silverXnoise/star-tracker/2377686/Star tracker - 2377686/images/729f3aaed75539d28fd95f96ef13848c.png

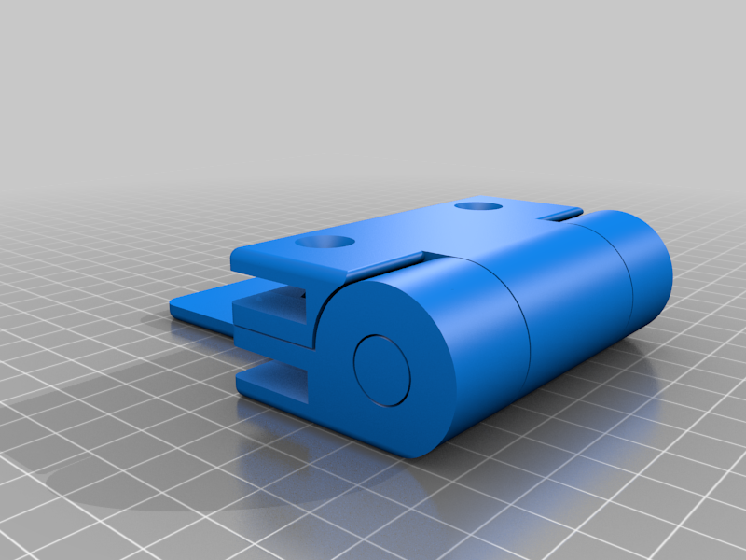
2377686/Star tracker - 2377686/images/729f3aaed75539d28fd95f96ef13848c.png
