silverXnoise/star-tracker/2377686/Star tracker - 2377686/images/P6115772_DxO.jpg

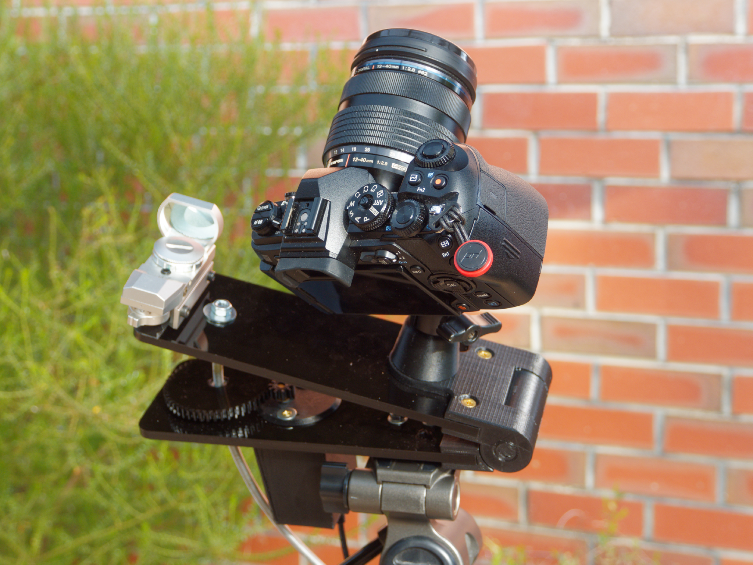
2377686/Star tracker - 2377686/images/P6115772_DxO.jpg
