silverXnoise/star-tracker/README.md

# star-tracker
Barn-door style star tracking mount for digital cameras
