silverXnoise/star-tracker/2377686/Star tracker - 2377686/images/2ce9118109a8682bafb783a583b2ab66.png

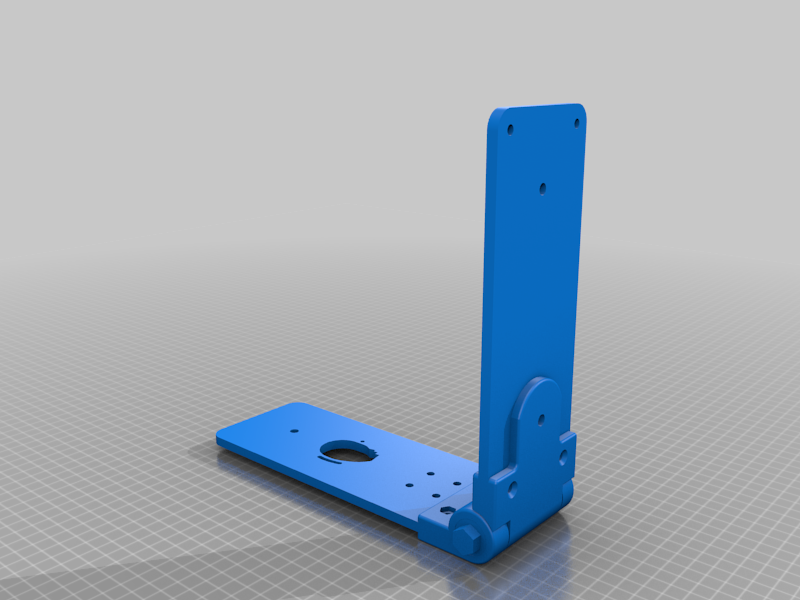
2377686/Star tracker - 2377686/images/2ce9118109a8682bafb783a583b2ab66.png
