silverXnoise/star-tracker/2377686/Star tracker - 2377686/images/5c67f773585e85fc1f77e3057208efd5.png

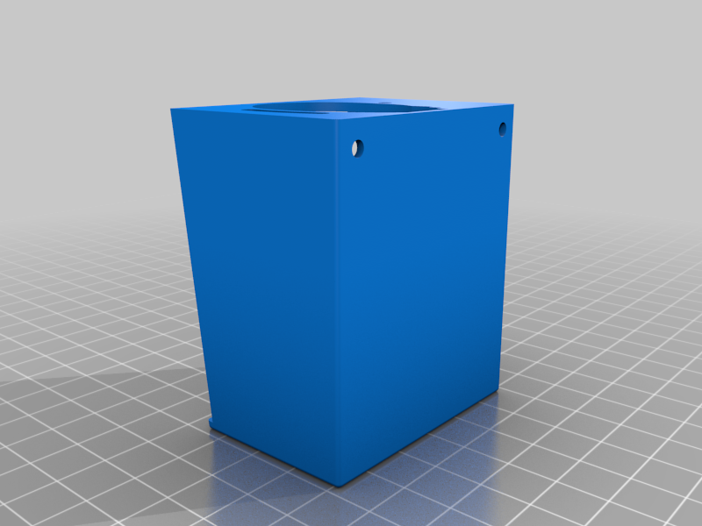
2377686/Star tracker - 2377686/images/5c67f773585e85fc1f77e3057208efd5.png
