silverXnoise/star-tracker/2377686/Star tracker - 2377686/images/5d4a4bc1e4c33faa9d85817317d7535b.png

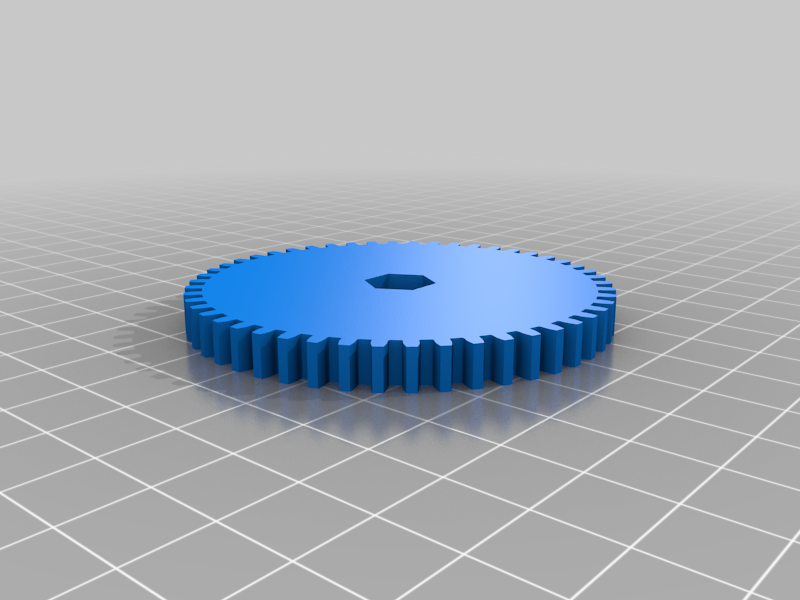
2377686/Star tracker - 2377686/images/5d4a4bc1e4c33faa9d85817317d7535b.png
