silverXnoise/star-tracker/2377686/Star tracker - 2377686/images/7db2c85e6fdb01128ebda68ac9ac53ee.png

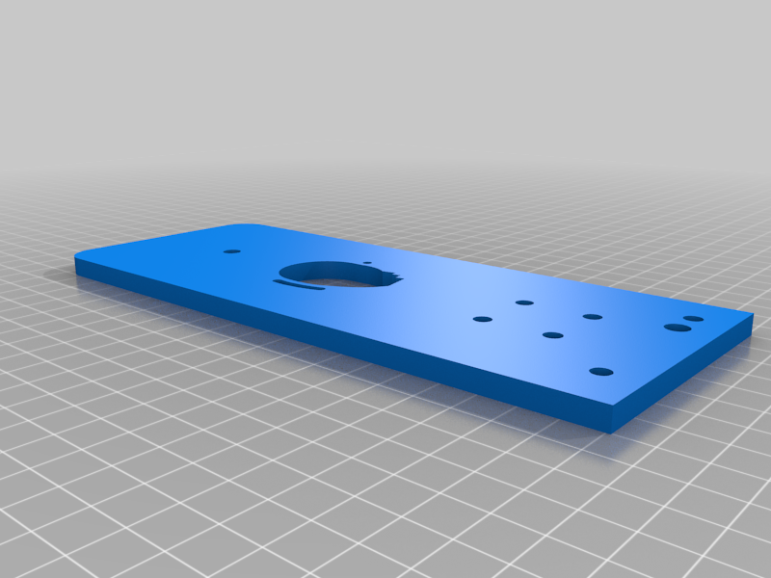
2377686/Star tracker - 2377686/images/7db2c85e6fdb01128ebda68ac9ac53ee.png
