silverXnoise/star-tracker/2377686/Star tracker - 2377686/images/26cda3ffb89d20ad288b1fc1c3eebb6a.png

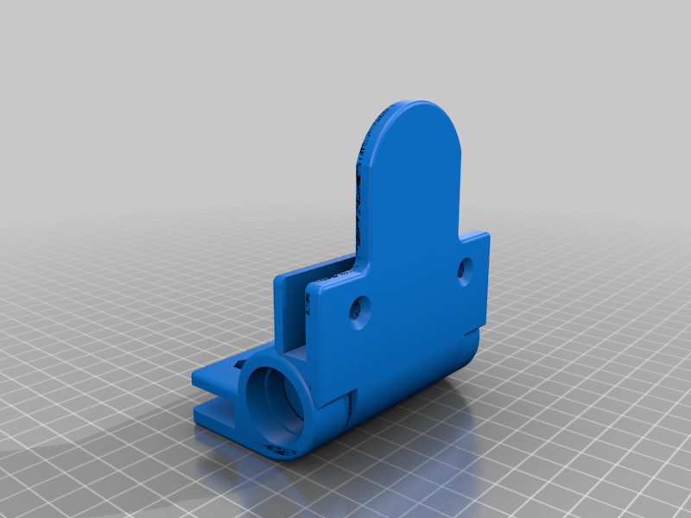
2377686/Star tracker - 2377686/images/26cda3ffb89d20ad288b1fc1c3eebb6a.png
