silverXnoise/star-tracker/2377686/Star tracker - 2377686/images/72ef2f90839a677f4413f9d10a9dccd0.png

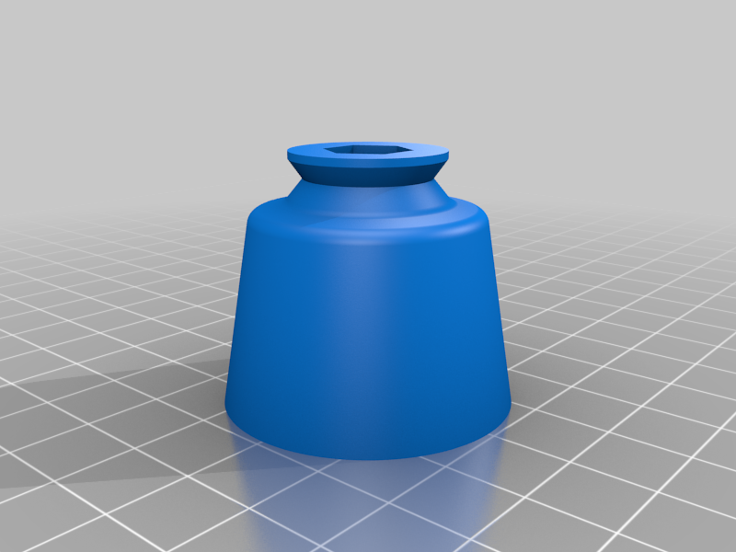
2377686/Star tracker - 2377686/images/72ef2f90839a677f4413f9d10a9dccd0.png
