silverXnoise/star-tracker/2377686/Star tracker - 2377686/images/74a210dba58315fb1523b2976943516c.png

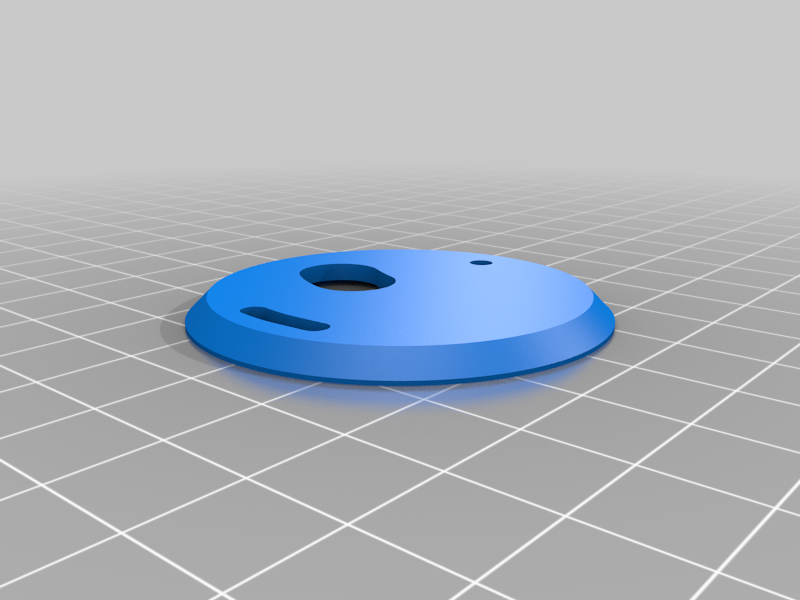
2377686/Star tracker - 2377686/images/74a210dba58315fb1523b2976943516c.png
