silverXnoise/star-tracker/2377686/Star tracker - 2377686/images/64908824dff2cc5d9ca0d351f06bbc23.png

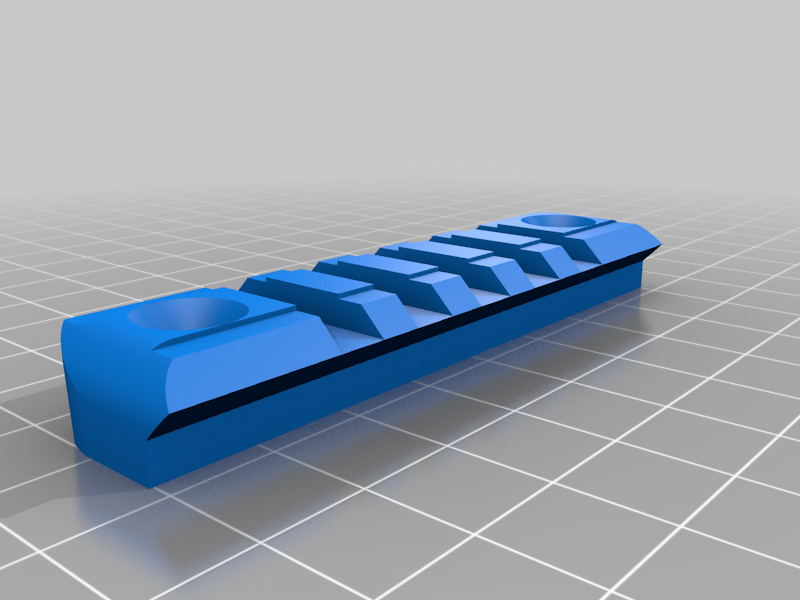
2377686/Star tracker - 2377686/images/64908824dff2cc5d9ca0d351f06bbc23.png
