silverXnoise/star-tracker/2377686/Star tracker - 2377686/images/189839108b3914b2a57e7a768595913c.png

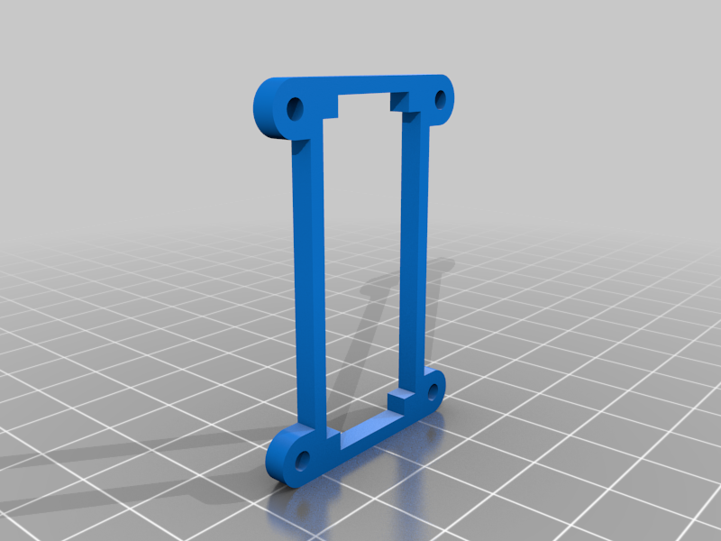
2377686/Star tracker - 2377686/images/189839108b3914b2a57e7a768595913c.png
