silverXnoise/star-tracker/2377686/Star tracker - 2377686/images/a8d63f5ceae4c1766cb8cda900a1fcd2.png

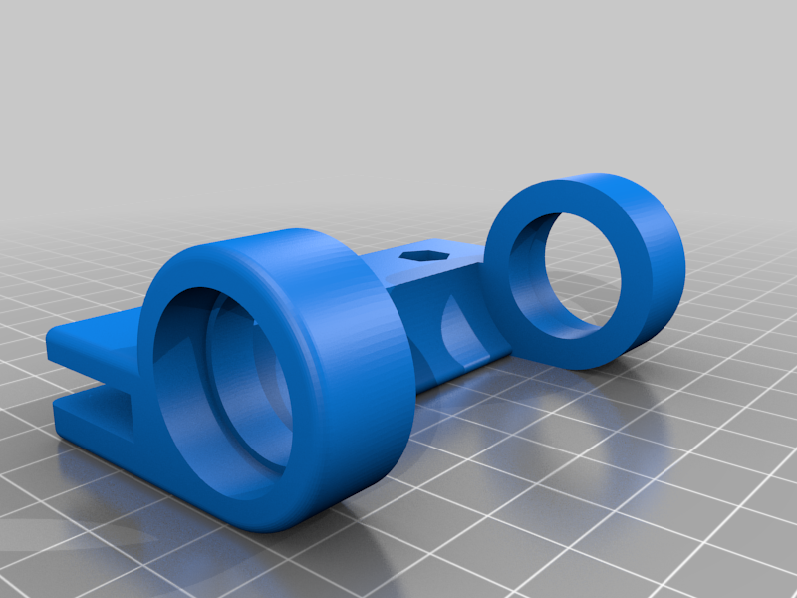
2377686/Star tracker - 2377686/images/a8d63f5ceae4c1766cb8cda900a1fcd2.png
