silverXnoise/star-tracker/2377686/Star tracker - 2377686/images/c061fdb549a10b3cd6e6b279aeabedf1.png

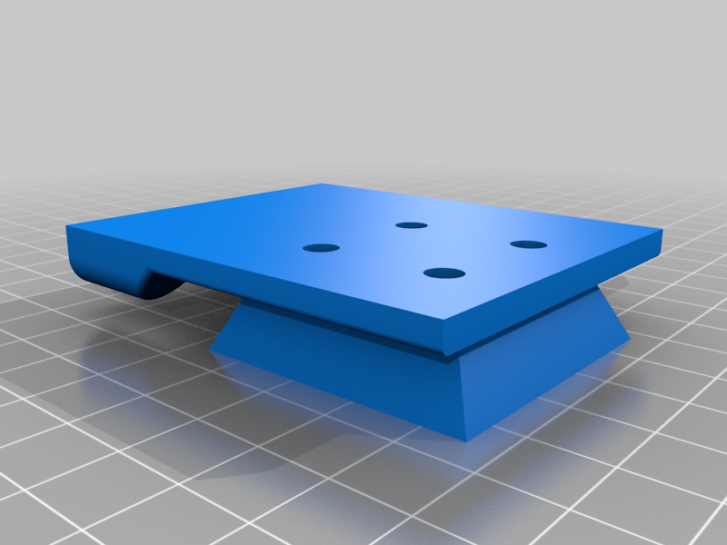
2377686/Star tracker - 2377686/images/c061fdb549a10b3cd6e6b279aeabedf1.png
