silverXnoise/star-tracker/2377686/Star tracker - 2377686/images/e7d88ce3950f14fdb1fe1683d85ecb0b.png

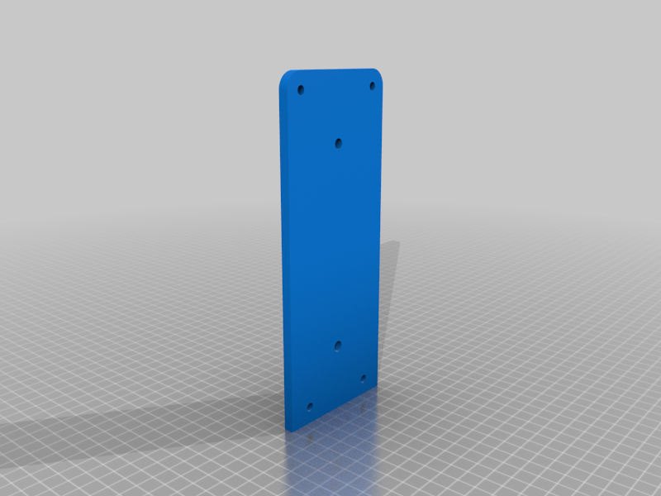
2377686/Star tracker - 2377686/images/e7d88ce3950f14fdb1fe1683d85ecb0b.png
