silverXnoise/star-tracker/2377686/Star tracker - 2377686/images/f91f4ea3223d18197822348a38beed8b.png

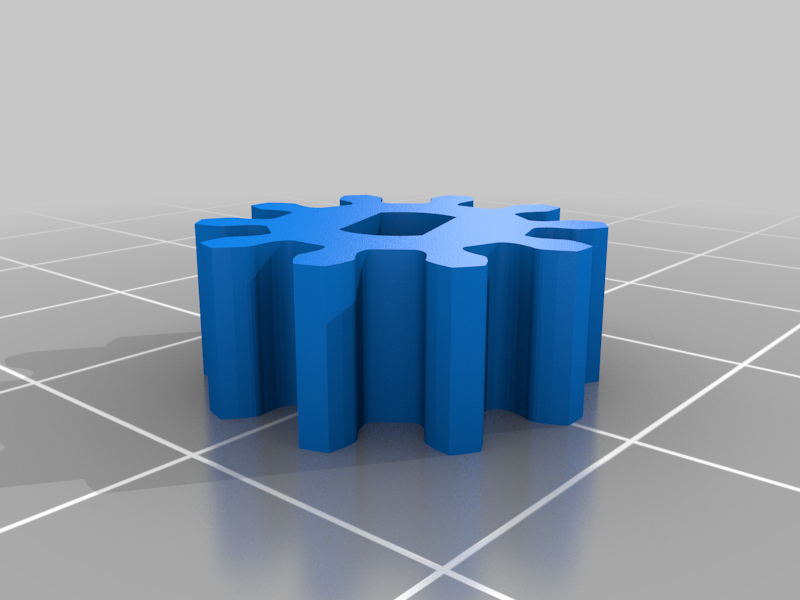
2377686/Star tracker - 2377686/images/f91f4ea3223d18197822348a38beed8b.png
