silverXnoise/star-tracker/2377686/Star tracker - 2377686/images/fdef6d9fbf967083d9055f6b1725dc97.png

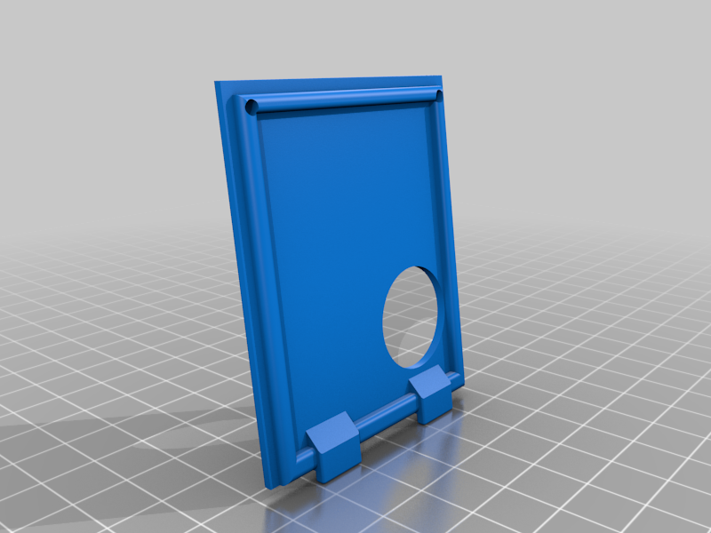
2377686/Star tracker - 2377686/images/fdef6d9fbf967083d9055f6b1725dc97.png
