silverXnoise/star-tracker/2377686/Star tracker - 2377686/images/Screen_Shot_2017-06-11_at_9.14.20_am.png

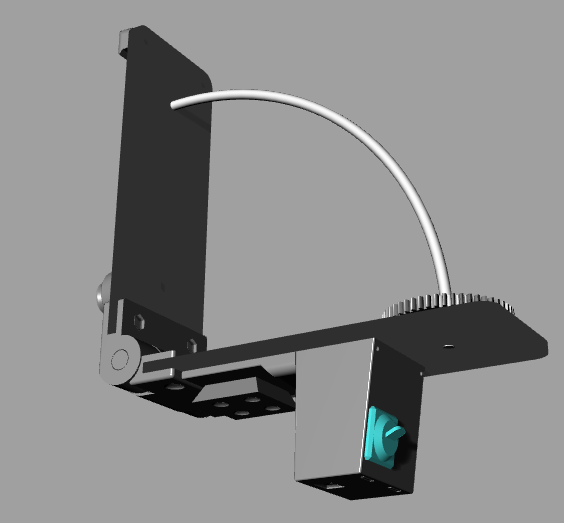
2377686/Star tracker - 2377686/images/Screen_Shot_2017-06-11_at_9.14.20_am.png
