silverXnoise/star-tracker/2377686/Star tracker - 2377686/images/Screen_Shot_2017-06-19_at_2.45.27_pm.png

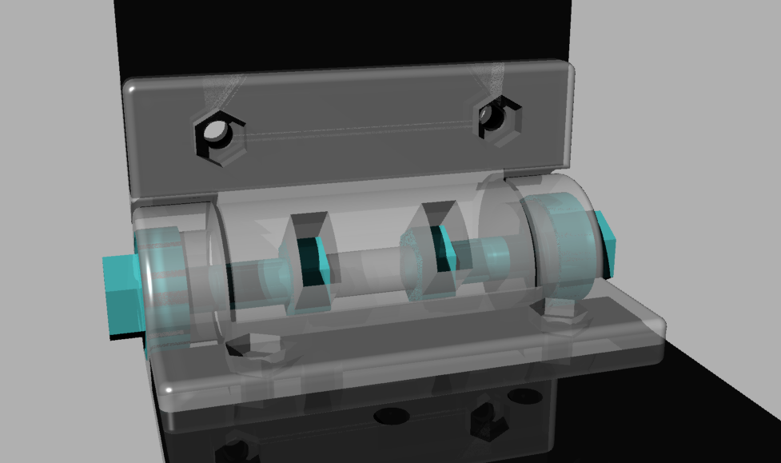
2377686/Star tracker - 2377686/images/Screen_Shot_2017-06-19_at_2.45.27_pm.png
