silverXnoise/star-tracker/2377686/Star tracker - 2377686/files/ST_Main_gear_0_OS.stl

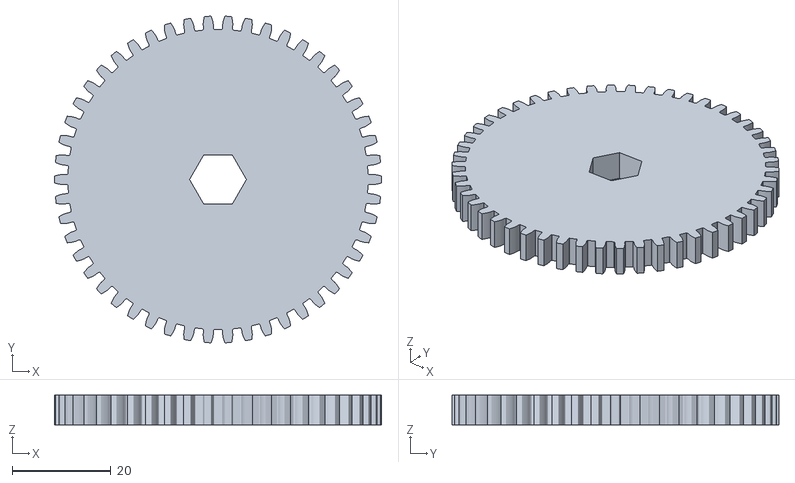
[picture p25: CAD file, 2024-02-19]
2377686/Star tracker - 2377686/files/ST_Main_gear_0_OS.stl
66.4 x 66.3 x 6.00
