silverXnoise/star-tracker/2377686/Star tracker - 2377686/files/Tripod_Foot.dxf

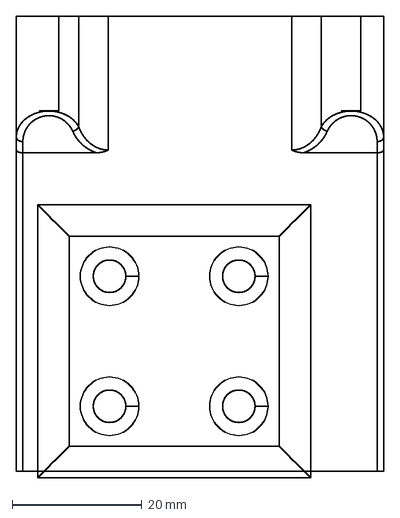
[picture p26: CAD file, 2024-02-19]
2377686/Star tracker - 2377686/files/Tripod_Foot.dxf
56.5 x 71.0 mm
