silverXnoise/star-tracker/2377686/Star tracker - 2377686/files/Bearing_hinge_interior.stl

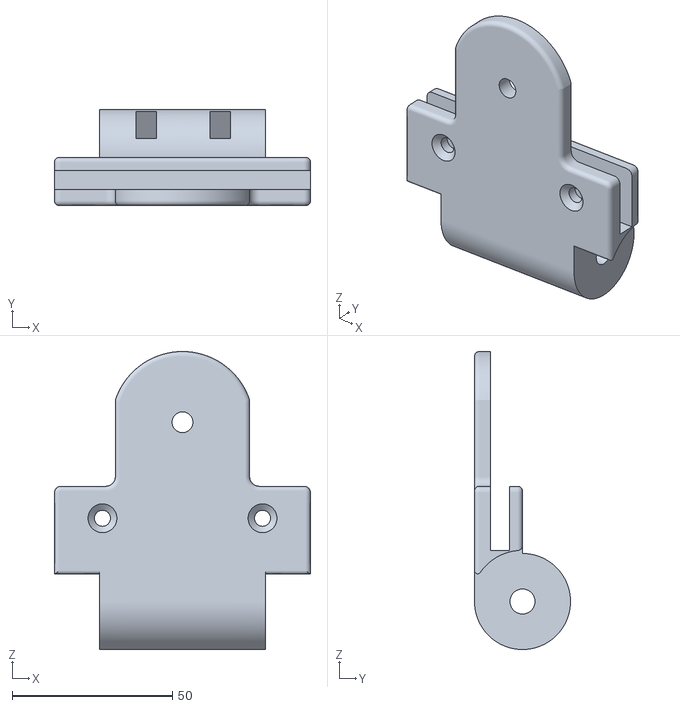
[picture p27: CAD file, 2024-02-19]
2377686/Star tracker - 2377686/files/Bearing_hinge_interior.stl
80.0 x 30.0 x 93.1
