silverXnoise/star-tracker/2377686/Star tracker - 2377686/files/ST_Arduino_cover.stl

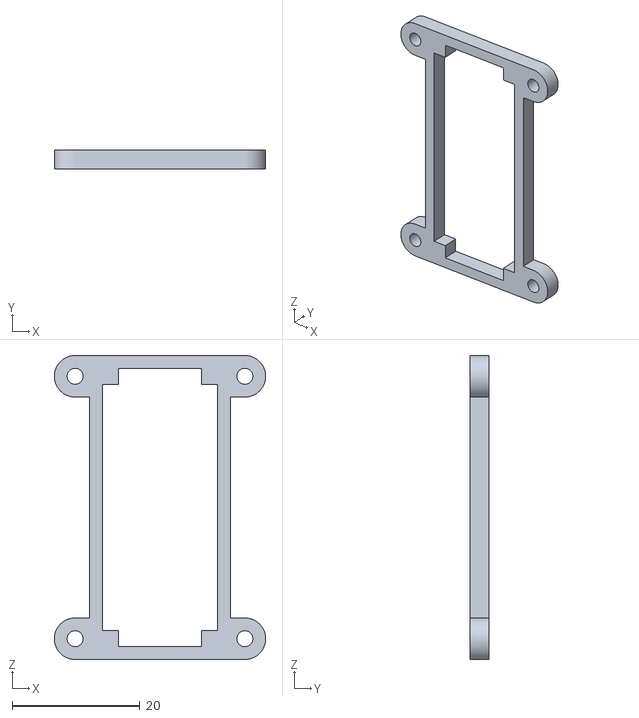
[picture p28: CAD file, 2024-02-19]
2377686/Star tracker - 2377686/files/ST_Arduino_cover.stl
33.0 x 3.00 x 47.5
