silverXnoise/star-tracker/2377686/Star tracker - 2377686/files/Panel_Bottom.stl

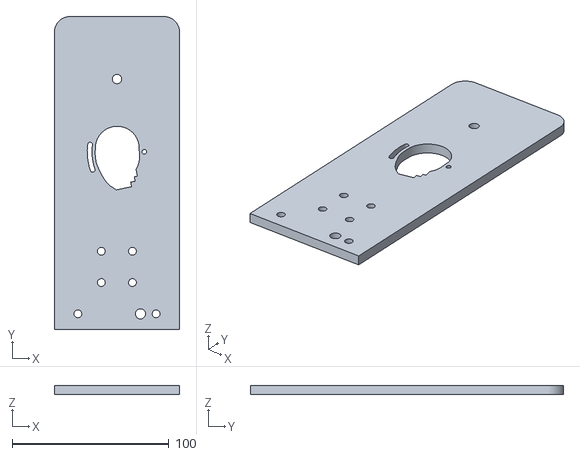
[picture p29: CAD file, 2024-02-19]
2377686/Star tracker - 2377686/files/Panel_Bottom.stl
80.0 x 200.0 x 6.00
