silverXnoise/star-tracker/2377686/Star tracker - 2377686/files/ST_Motor_cover.stl

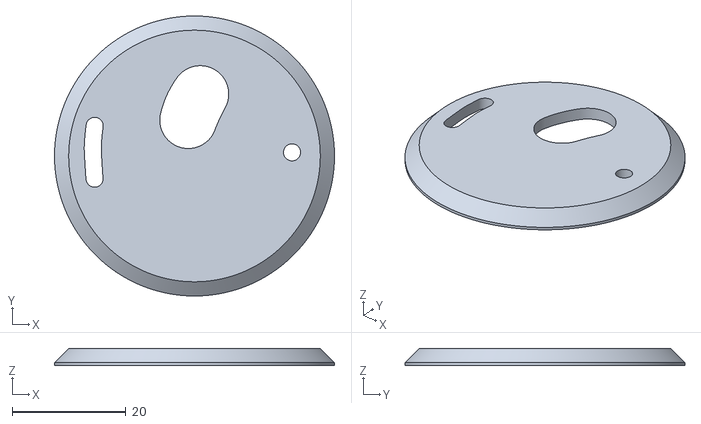
[picture p30: CAD file, 2024-02-19]
2377686/Star tracker - 2377686/files/ST_Motor_cover.stl
49.2 x 49.2 x 3.00
