silverXnoise/star-tracker/2377686/Star tracker - 2377686/files/ST_Sight_Mount.stl

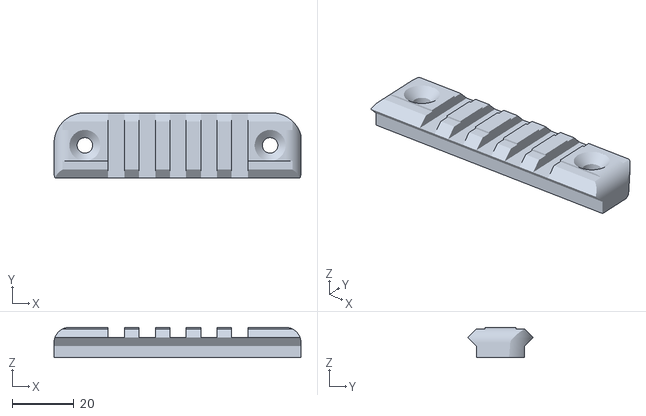
[picture p31: CAD file, 2024-02-19]
2377686/Star tracker - 2377686/files/ST_Sight_Mount.stl
80.0 x 21.2 x 9.82
