silverXnoise/star-tracker/2377686/Star tracker - 2377686/files/Bearing_hinge_exterior.stl

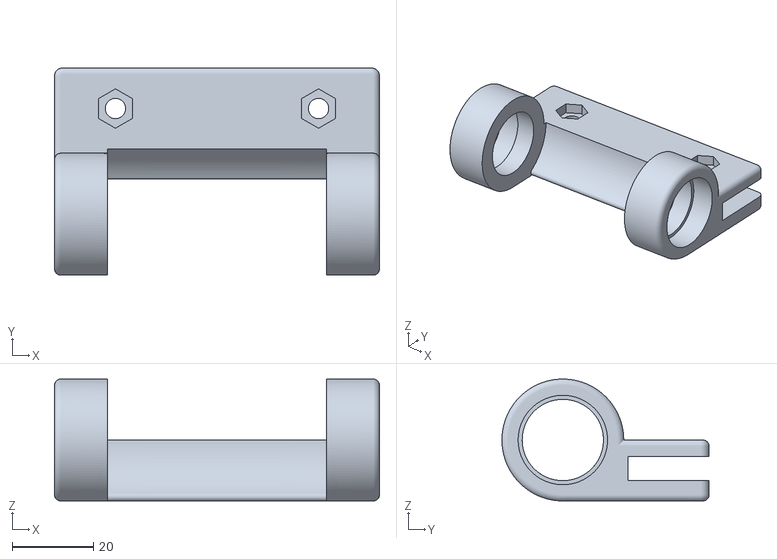
[picture p32: CAD file, 2024-02-19]
2377686/Star tracker - 2377686/files/Bearing_hinge_exterior.stl
80.0 x 51.0 x 30.0
