silverXnoise/star-tracker/2377686/Star tracker - 2377686/files/Panel_Top.stl

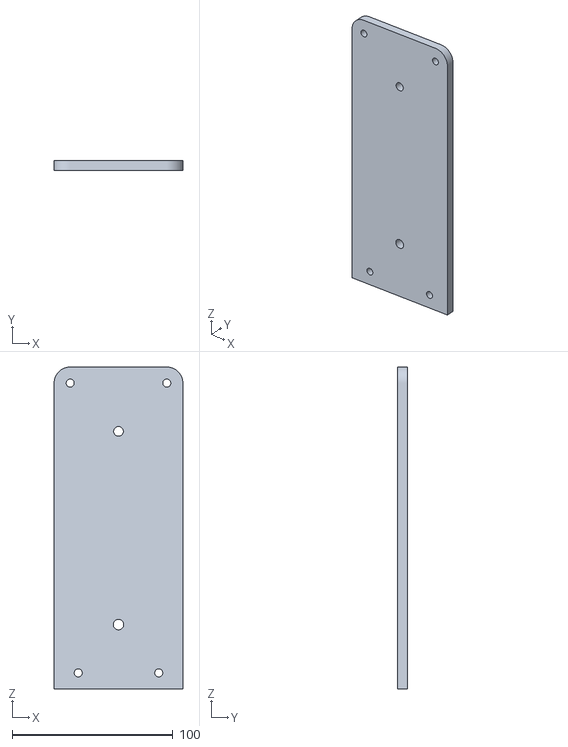
[picture p33: CAD file, 2024-02-19]
2377686/Star tracker - 2377686/files/Panel_Top.stl
80.0 x 6.00 x 200.0
