silverXnoise/star-tracker/2377686/Star tracker - 2377686/files/ST_Panels.dxf

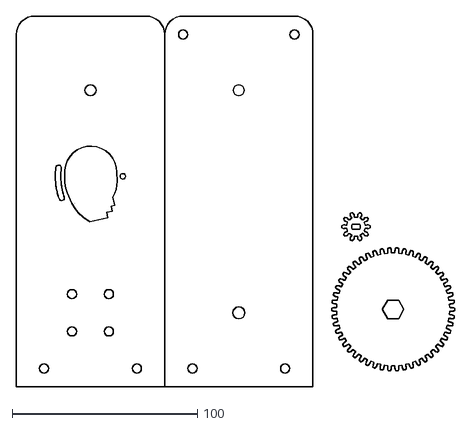
[picture p34: CAD file, 2024-02-19]
2377686/Star tracker - 2377686/files/ST_Panels.dxf
236.4 x 200.0
