silverXnoise/star-tracker/2377686/Star tracker - 2377686/files/ST_Small_gear_0_and_0.1OS.stl

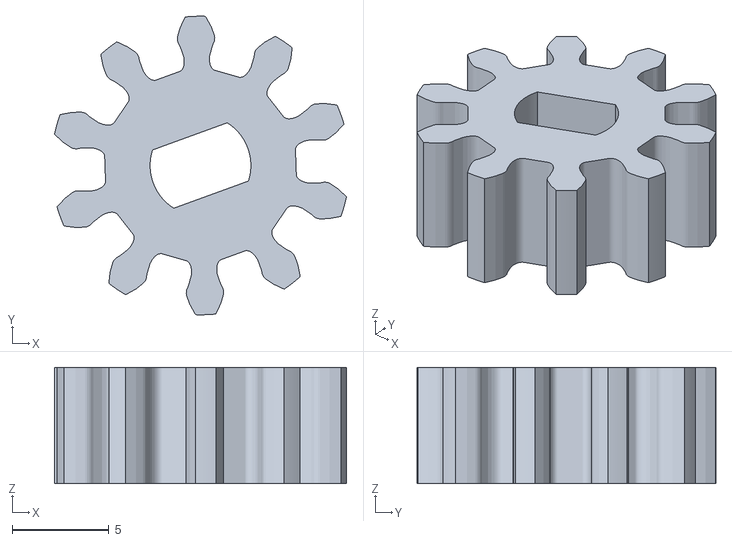
[picture p35: CAD file, 2024-02-19]
2377686/Star tracker - 2377686/files/ST_Small_gear_0_and_0.1OS.stl
15.1 x 15.4 x 6.00
