silverXnoise/star-tracker/(list of files, cad)

Other CAD files:
2377686/Star tracker - 2377686/files/Tripod_foot.3dm
